GonzaloRomeroR/Robot-Teleoperation-Unity/img/Fabrica.PNG

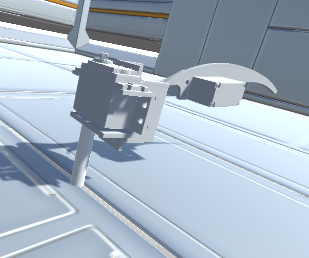
img/Fabrica.PNG
