GonzaloRomeroR/Robot-Teleoperation-Unity/img/12-datos.PNG

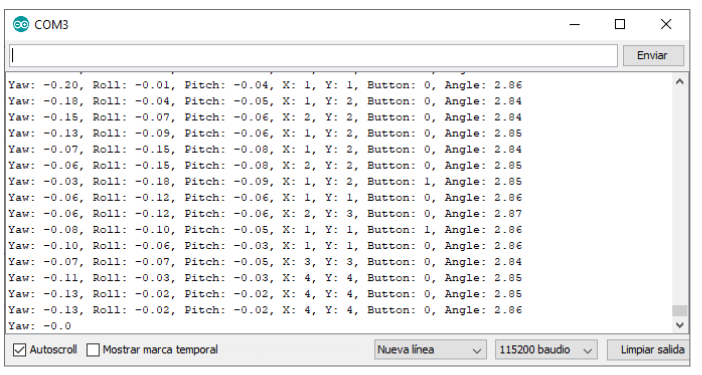
img/12-datos.PNG
