GonzaloRomeroR/Robot-Teleoperation-Unity/img/2-sistema.PNG

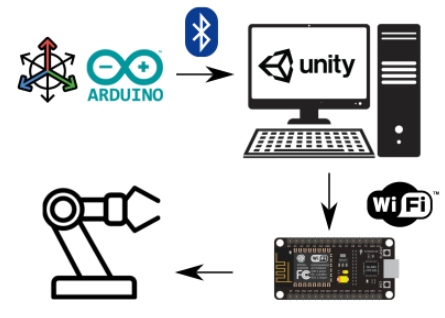
img/2-sistema.PNG
