GonzaloRomeroR/Robot-Teleoperation-Unity/img/5-Ecuaciones.PNG

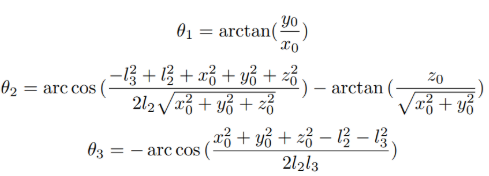
img/5-Ecuaciones.PNG
