GonzaloRomeroR/Robot-Teleoperation-Unity/img/6-6050.PNG

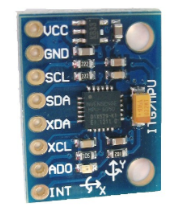
img/6-6050.PNG
