GonzaloRomeroR/Robot-Teleoperation-Unity/img/8-Arduino.PNG

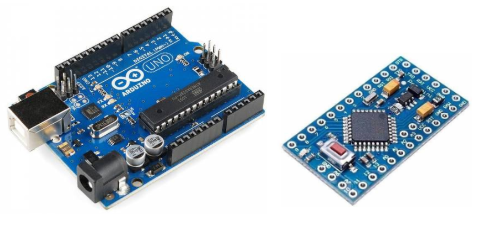
img/8-Arduino.PNG
