GonzaloRomeroR/Robot-Teleoperation-Unity/img/10-pca.PNG

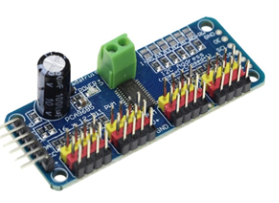
img/10-pca.PNG
