GonzaloRomeroR/Robot-Teleoperation-Unity/img/17-pieza2.PNG

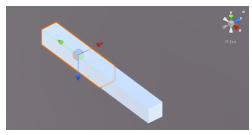
img/17-pieza2.PNG
