GonzaloRomeroR/Robot-Teleoperation-Unity/img/20-simul1.PNG

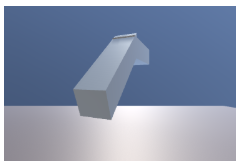
img/20-simul1.PNG
