GonzaloRomeroR/Robot-Teleoperation-Unity/img/22-simul2.PNG

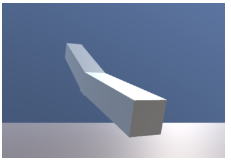
img/22-simul2.PNG
