GonzaloRomeroR/Robot-Teleoperation-Unity/img/25-data.PNG

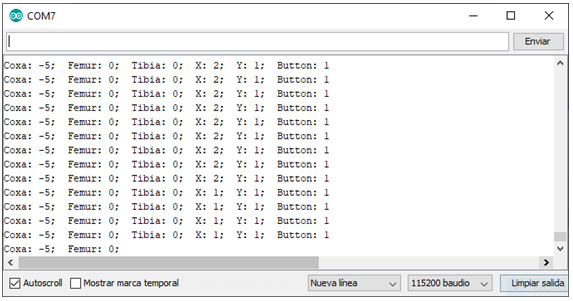
img/25-data.PNG
