GonzaloRomeroR/Robot-Teleoperation-Unity/img/26-conexion.PNG

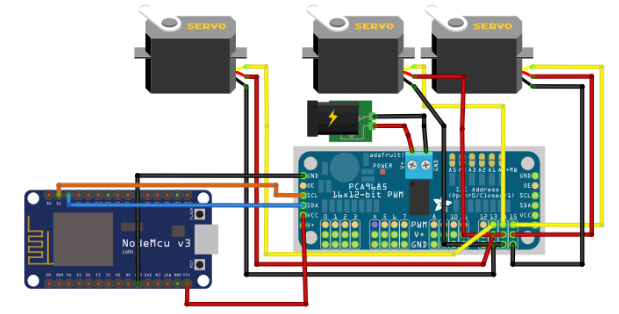
img/26-conexion.PNG
