GonzaloRomeroR/Robot-Teleoperation-Unity/img/30-pers1.PNG

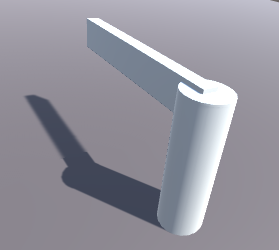
img/30-pers1.PNG
