GonzaloRomeroR/Robot-Teleoperation-Unity/img/30-pers2.PNG

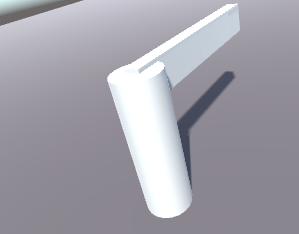
img/30-pers2.PNG
