GonzaloRomeroR/Robot-Teleoperation-Unity/img/entorno.PNG

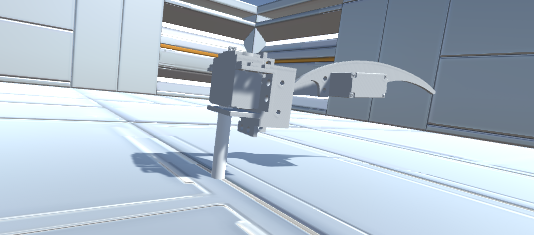
img/entorno.PNG
