GonzaloRomeroR/Robot-Teleoperation-Unity/img/mine_kin.PNG

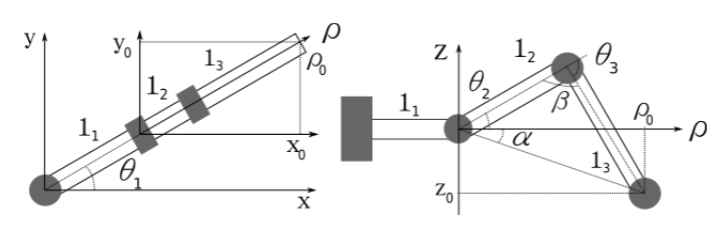
img/mine_kin.PNG
