GonzaloRomeroR/Robot-Teleoperation-Unity/img/Pieza1.PNG

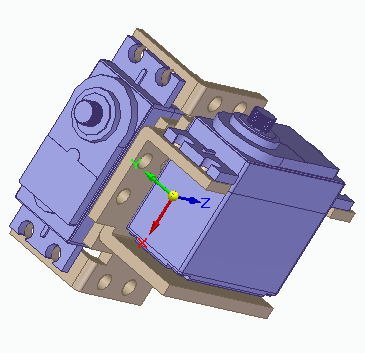
img/Pieza1.PNG
