GonzaloRomeroR/Robot-Teleoperation-Unity/img/Pieza2.PNG

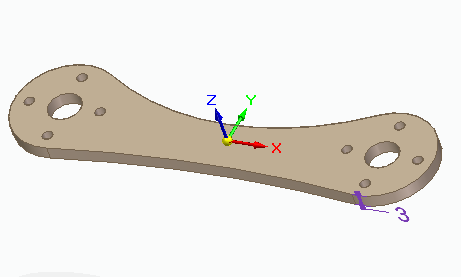
img/Pieza2.PNG
