GonzaloRomeroR/Robot-Teleoperation-Unity/img/Pieza3.PNG

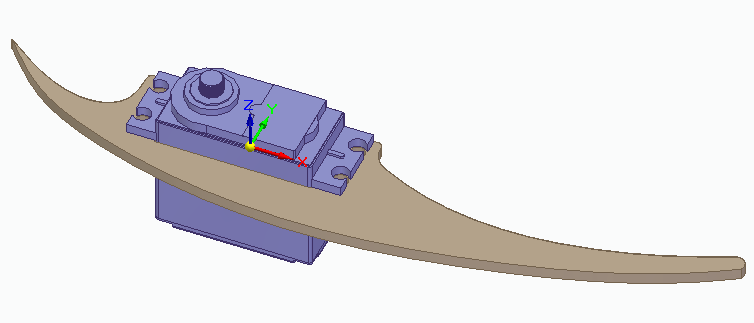
img/Pieza3.PNG
