GonzaloRomeroR/Robot-Teleoperation-Unity/img/Piezas.png

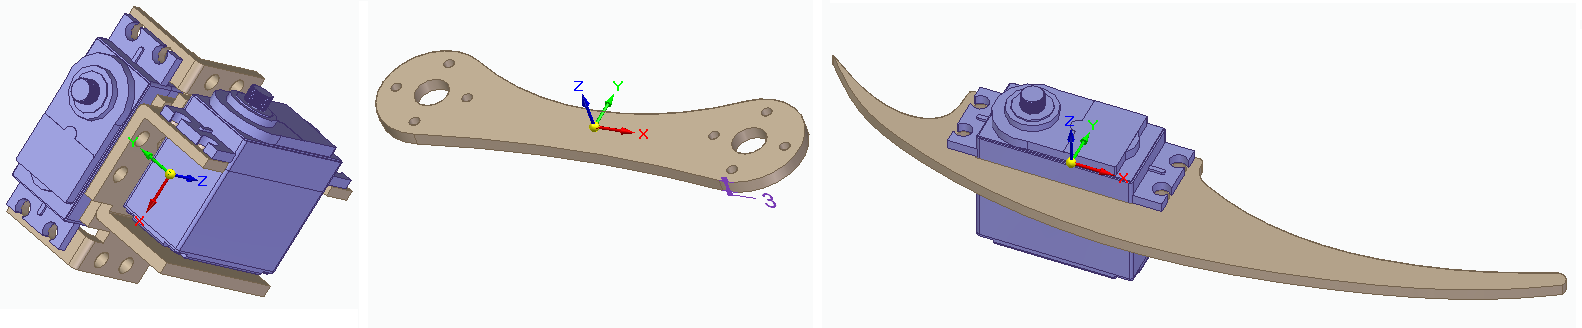
img/Piezas.png
