GonzaloRomeroR/Robot-Teleoperation-Unity/img/Solid.PNG

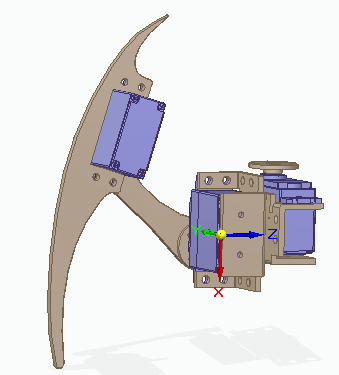
img/Solid.PNG
