GonzaloRomeroR/Robot-Teleoperation-Unity/(list of files, drawings)

Other design files:
controller/Controller.fzz
